stcapo/slmw/Phase_1_Review_report.md

# Phase 1 任务 Review 汇报

> Review 更新日期：2026-05-21  
> 范围：第一阶段任务、开发板选型、最终订单、采购风险边界

## 1. 最新结论

2026-05-15 版本曾将 T3-3S 作为第一阶段固定采购模组。该口径已被 2026-05-21 最终订单覆盖。

当前第一阶段主路径固定为：

```text
T5AI-Core
  -> 两路 3.3V PWM
  -> YYNMOS-4 / NMOS-4 (3-5V) MOSFET 模块
  -> 12V 恒压双色温/三色 LED 灯带
  -> 12V2A 成品隔离电源
```

核心判断：

- 可行路径：先用 T5AI-Core 和 12V 低压 LED 负载跑通 App/固件/PWM/MOSFET/灯带闭环。
- 暂不建议路径：继续购买更多开发板或围绕裸模组转接板打转。
- 后置路径：24V 需确认电源条件后再测；48V 宽压 Buck 与 48V 功率级进入 Phase 2。
- 产品化路径：最终 PCB 不直接照搬 T5AI-Core 和 YYNMOS-4，需要重新做模组、Buck、MOSFET、布局和热设计。

## 2. 已更新文件

| 文件 | 更新内容 |
| --- | --- |
| `采购现方案.md` | 改为 T5AI-Core 第一阶段最终下单版，加入截图订单明细、金额、运费、执行顺序和边界 |
| `Phase 1 原采购清单.md` | 同步 T5AI-Core 主路径、最终 BOM、验收标准和后置项 |
| `tuya_wb_3_s_solution.md` | 改为 T5AI-Core 校正版方案摘要 |
| `Agents.md` | 更新项目级口径，避免继续按 T3-3S 固定采购执行 |

## 3. 最终订单金额

| 项目 | 金额 |
| --- | ---: |
| 商品小计 | ¥1094.85 |
| 运费小计 | ¥15.00 |
| 订单总计 | ¥1109.85 |

金额按用户提供的确认订单截图记录，使用补贴后/优惠后价格。

## 4. 金额最高的核心物料

| 排名 | 物料 | 数量 | 金额 | 作用 |
| ---: | --- | ---: | ---: | --- |
| 1 | UT61E PRO 数字万用表 | 1 | ¥395.01 | 基础电测工具 |
| 2 | Kingst LA1010 逻辑分析仪 | 1 | ¥298.00 | 测 PWM/数字信号 |
| 3 | T5AI-Core 开发板 | 1 | ¥88.00 | 第一阶段主开发板 |
| 4 | 涂鸦 WiFi+蓝牙五合一 LED 控制器 | 1 | ¥68.31 | 成品对照 |
| 5 | TA610A K 型热电偶温度计 | 1 | ¥49.00 | 温升测试 |
| 6 | YYNMOS-4 / NMOS-4 (3-5V) MOSFET 模块 | 2 | ¥29.52 | 原型功率级 |

完整订单表以 `采购现方案.md` 为准。

## 5. 剩余风险

1. `YYNMOS-4 / NMOS-4` 标称最大 PWM 频率为 500Hz，第一阶段只验证原型闭环；最终产品仍应设计更高频功率级。
2. 订单中有 24V 负载，但未看到独立 24V 电源适配器；没有 24V 安全电源前，不做 24V 上电。
3. LM2596 模块不是 48V 宽压方案，不能证明 12V-48V 通用输入已经完成。
4. 灯带到货后必须确认线序、共阳/共阴和每路功率，再决定具体接线。
5. T5AI-Core 是开发板，不是最终可塞进灯具里的量产中间层。

## 6. 建议下一步

下单后停止继续扩展候选件。到货后按 `采购现方案.md` 的执行顺序，从 T5 单板上电、PWM 测量、12V 灯带闭环、温升记录四步推进。
