stcapo/slmw/handover.md

# 项目交接文档 · Handover

> 更新日期：2026-05-27  
> 项目：通用智能灯具中间层解决方案  
> 当前阶段：Phase 1 — 双路双色温硬件闭环已通过，下一步进入 Tuya App 配网/控制验证

---

## 一、项目背景（一句话）

打造一个模块化"智能中间层"，让传统灯具无需改动驱动器即可接入涂鸦 App，实现 WiFi/Zigbee 控制开关、亮度、色温。目标市场：海外非标、异形造型灯具。

---

## 二、已做过的决策（不再重复讨论）

| 决策 | 结论 | 备注 |
|---|---|---|
| 主开发板 | **T5AI-Core** 唯一主路径 | T2-U/T3-3S/WB3S/NANO 已排除出 Phase 1 |
| MOSFET 模块 | **YYNMOS-4 (3-5V)** × 2 | 原型验证用，标称最大 500Hz，不作为量产电路 |
| LED 负载 | 12V 单色灯带（优先）+ 12V/24V 双色温灯带 | 到货已确认线序 |
| 主供电 | 12V 2A 成品适配器 | 实测 12.25V，通过 |
| 工具 | UT61B+ 万用表 + LA1010 逻辑分析仪 + TA610A 热电偶 | 万用表已用电池验证 |
| 备板 | NiceMCU WB3S V1 仅作支线对照 | 不影响主路径 |
| 采购总计 | **¥1109.85**（商品 ¥1094.85 + 运费 ¥15.00） | 2026-05-21 订单，已全部到货 |

---

## 三、物料到货状态

| 物料 | 状态 |
|---|:----:|
| T5AI-Core 开发板 | ✅ 已到货 |
| YYNMOS-4/NMOS-4 MOSFET 模块 × 2 | ✅ 已到货 |
| DC 转接头 | ✅ 已到货 |
| 线材（杜邦线等） | ✅ 已到货 |
| 12V 单色暖白灯带 | ✅ 已到货 |
| 12V/24V 双色温灯带 | ✅ 已到货 |
| 12V 2A 电源适配器 | ✅ 已到货 |
| 小螺丝刀 | ✅ 已到货 |
| 万用表尖表笔 | ✅ 已到货 |
| **剥线钳** | ❌ 待补购（后续线头处理建议优先） |
| **剪钳** | ❌ 待补购（后续剪灯带建议优先） |
| 绝缘胶带 | ❌ 待补购 |
| 热缩管 | ❌ 待补购 |
| 镊子 | ❌ 待补购 |
| 打火机 / 热风枪 | ❌ 待补购（热缩管配套，可稍后） |

> ⚠️ 剥线钳和剪钳仍建议补购，用于后续更可靠地处理线头；Step 10 已用现有单根杜邦线/细鳄鱼夹/剪刀临时方案完成。

---

## 四、主线实施进度

### ✅ 已完成步骤

| 步骤 | 内容 | 关键结果 |
|---|---|---|
| Step 1 | T5AI-Core 单板上电 | 发现电源开关未打开的坑；打开后通过 |
| Step 2 | 电脑识别串口 | 枚举出 CH342F 双串口：`551`（下载）和 `553`（日志） |
| Step 3 | 串口日志查看 | TuyaOpen Tools 460800 波特率可看启动日志 |
| Step 4 | 万用表测 5V/3.3V | 5V ≈ 正常，3.3V ≈ 正常（需电源开关开启） |
| Step 5 | 烧录 PWM 冒烟测试程序 | Arduino IDE + TUYA_T5AI_CORE，写入成功，CRC 通过 |
| Step 6 | PWM 输出确认 | P24/P25 输出 200Hz 方波，占空比随程序 3 秒循环变化 |
| Step 7 | LA1010 逻辑分析仪抓波形 | 两路周期性方波已确认 |
| Step 8 | 12V 电源单独测量 | 实测 12.25V，内正外负，通过 |
| Step 9 | MOSFET 端子识别 | 丝印确认：PWM1~4 / GND1~4 / DC+ DC- / OUT1~4 ± |
| Step 10 | T5 → MOSFET → 12V 单色灯带闭环 | P24 → PWM1 成功驱动单色暖白灯带，亮度每 3 秒按 10%→50%→90%→0%→100% 变化 |
| Step 11 | P24/P25 双路双色温混光 | 双色温灯带共阳线序确认；双路 MOSFET 控制有变化；极限冷/暖两档测试通过 |

### 🔄 当前主线

**Step 11 已通过：T5AI-Core P24/P25 PWM → YYNMOS-4 PWM1/PWM2 → 12V 双色温灯带双路硬件闭环验证成功。**

关键结果：
- T5AI-Core 重新 USB 上电后，串口持续输出 `PWM_A P24 duty=...` 日志
- 12V 单色暖白灯带按预期每 3 秒经历：暗 → 中 → 亮 → 灭 → 全亮
- 说明控制侧共地、PWM1 输入、MOSFET 低边开关、12V 功率侧和 LED 极性均已跑通
- 12V/24V 双色温灯带线序已确认：红线为公共正极，黄线 WW 接负极亮暖白，白线 CW 接负极亮冷白
- `firmware/t5_cct_extreme_test/t5_cct_extreme_test.ino` 极限测试通过，冷白/暖白两档区别明确
- 冷白通道在 200Hz 下肉眼可感知闪烁，记录为原型频率风险；YYNMOS-4 标称 500Hz 上限内先不强行升频，产品化功率级后续目标应提升到 2kHz 以上

### ⏸ 待执行（下一步）

1. **执行 Step 12：Tuya App 配网/控制验证**
   ```
   App 配网
   App 开关控制
   App 亮度控制
   App 色温控制
   ```
2. **仍建议补购剥线钳、剪钳、绝缘胶带、热缩管**：后续双路/双色温线头更多，剪刀方案只能临时用。
3. **Phase 1 最终验收标准**：手机 App 可控制开关、亮度、色温；物理 PWM 闭环只是中间里程碑。

---

## 五、支线进度（NiceMCU WB3S V1）

> 纯玩备板，不影响主线任何决策。

| 步骤 | 状态 | 关键信息 |
|---|:----:|---|
| USB 上电 + 串口识别 | ✅ | 波特率 115200 |
| 查看启动日志 | ✅ | `BK7238_1.0.14` / `RT-Thread OTA` / `www.sparkleiot.com` / `ready` |
| AT 命令查询 | ✅ | AT OK，ATVER 1.1，SDKVER 3.0.70，Wi-Fi MAC `c8:47:8c:01:12:1f` |
| Wi-Fi 扫描 + 入网 | ✅ | 获取 IP `192.168.1.47`，可用 `AT+CWLAP` / `AT+WSCAN` |
| TCP 通信 | ✅ | `AT+CIPSEND=0,5` 成功发送，电脑 `nc -lk 8080` 可收到数据 |
| 下一步 | ⏸ | 支线暂停，等主线双路混光/App 控制稳定后再继续 |

---

## 六、开发环境信息

| 项目 | 信息 |
|---|---|
| 电脑系统 | macOS 12.7.6 |
| T5 下载串口 | `/dev/cu.usbmodem5AAE1666551` |
| T5 日志串口 | `/dev/cu.usbmodem5AAE1666553` |
| Arduino IDE 版本 | IDE 2，开发板包：Tuya Open |
| 开发板包地址 | `https://github.com/tuya/arduino-tuyaopen/releases/download/global/package_tuya_open_index.json` |
| 国内备用地址 | `https://gitee.com/tuya-open/arduino-tuyaopen/releases/download/global/package_tuya_open_index_cn.json` |
| 开发板选择 | `TUYA_T5AI_CORE` |
| 日志波特率 | **460800**（TuyaOpen Tools）或 Arduino Serial Monitor 115200 |
| PWM 程序路径 | `firmware/t5_pwm_smoke_test/t5_pwm_smoke_test.ino` |
| PWM 引脚 | P24（PWM_A）、P25（PWM_B），200Hz，占空比 3 秒一循环 |

---

## 七、关键边界与禁止事项

| 事项 | 说明 |
|---|---|
| **12V 绝不接 T5** | T5 用 Type-C 供电，12V 只进 MOSFET 模块和灯带 |
| **不碰 220V** | 第一阶段全程低压 DC，不接市电 |
| YYNMOS-4 频率上限 | 标称 500Hz，程序设为 200Hz，不作为量产最终电路 |
| LM2596 Buck | 只做 12V/24V 台架验证，不代表 48V 宽压方案完成 |
| 24V 测试前提 | 必须有可靠 24V 电源，不能用当前 18.5V 测 12V 负载 |
| 5-in-1 成品控制器 | 接负载后无响应，疑似损坏，已暂停不再折腾 |

---

## 八、Phase 2 当前计划（T3-3S 首板）

> 2026-06-08 更新：Phase 2 Wi-Fi 主线已锁定为 T3-3S，首板按 4 周稳妥节奏推进，由项目负责人做 PM + 技术评审，新PCB工程师 / PCB 工程师负责原理图、PCB Layout、BOM、打样文件和样板焊接配合。

- 首板目标：`T3-3S + 12/24V 输入 + 3.3V Buck + 双路低边 MOSFET + 共阳双色温 LED 输出`。
- 首板边界：低压控制 PCB，不做 220V 市电板载电源，不做 48V 宽压，不做 Zigbee，不追求极限小型化。
- PWM 映射：`T3-3S P24 -> WW`，`T3-3S P32 -> CW`，并预留 `3V3/GND/TX1/RX1/CEN/P24/P32` 测试点。
- PCB 重点：严格按 T3-3S datasheet 推荐封装建库；天线区不走线、不覆铜；keep-out 区域不上锡、不走线。
- 验收标准：12V/24V 输入均能稳定输出 3.3V；两路 PWM 可测；WW/CW 可独立驱动；30 分钟运行无异常发热、异味、重启或电源异常。
- 执行文档：
  - `Phrase2/phase2_t3_3s_pcb_schedule.md`
  - `Phrase2/phase2_t3_3s_pcb_review_checklists.md`
  - `Phrase2/phase2_t3_3s_status_log.md`

仍后移事项：

- 48V 宽压版本。
- Zigbee 版本。
- 板载 AC-DC 市电方案。
- 量产成本、认证、EMC、极限尺寸优化。

---

## 九、参考文档

| 文档 | 说明 |
|---|---|
| `Phase_1_实施手册.md` | 最权威的操作步骤，含所有实测记录 |
| `采购现方案0521.md` | 最终下单清单，金额明细 |
| `Agents.md` | 项目整体架构与三阶段计划 |
| `Phrase2/phase2_t3_3s_pcb_schedule.md` | Phase 2 T3-3S PCB 4 周排期与协作计划 |
| `Phrase2/phase2_t3_3s_pcb_review_checklists.md` | Phase 2 原理图、BOM、Layout、Gerber、Bring-up 检查清单 |
| `Phrase2/phase2_t3_3s_status_log.md` | Phase 2 站会、评审、变更、问题和测试记录模板 |
| T5AI-Core 官方文档 | https://www.tuyaopen.ai/zh/docs/hardware-specific/tuya-t5/t5-ai-core/overview-t5-ai-core |
