stcapo/slmw/Phrase2/meeting_summary_0527.txt

灯具智能控制方案及中间层设计讨论

说话人1：先讲流驱动和稳压驱动，二者区别在于输入分别为恒流、恒压。LED灯具多为串联结构，适配恒流驱动与恒压驱动。家用市电为220V，需先降压转为直流电才能驱动LED。目前行业主流做法是将控制单元集成在驱动内部，通过外置天线接收信号，实现灯具通断控制。

我们计划在LED驱动与灯体之间增设一层独立控制单元（中间层），该中间层具备宽压适配能力，可接收信号、管控灯具开关，无需原有驱动具备智能功能。该模块可对外供货给各类灯饰厂商，搭配配套服务器、APP及通信协议，就能让普通灯具接入整套智能系统。

传统智能灯具方案存在明显弊端：单独采购智能驱动成本高、适配难度大，尤其造型复杂、设计感强的花灯，很难直接配套现成智能驱动，往往需要单独定制适配，成本和门槛都很高。

再说明LED灯具色温、亮度的控制原理：灯具分为暖光、冷光两组灯珠，不同色温是通过调节两组灯珠亮度混合实现；单独点亮暖光/冷光对应单色光，同时点亮则为中性光。灯具亮度调节本质是调控回路电流，传统方式会加装电阻分流，也有PID调光等主流调光技术。

业内涂鸦智能就是主打售卖这类智能控制模块，可作为参考。整套系统需要搭建网关并制定通信协议：常供电的灯具可采用2.4G通信，电池供电设备适配蓝牙、Zigbee。网关作为中枢，可接入所有搭载中间层模块的灯具；2.4G方案还可直连WiFi，无需额外网关。

海外市场对灯具外观设计、个性化定制要求极高，市面上主流通用智能方案难以适配异形灯具，这也是我们方案的机会点。灯具主要分为传统螺口灯泡和LED面板灯、筒灯、吸顶灯两大类：螺口灯泡可直接将智能模块集成在灯体内部，适合批量生产；异形灯具则依靠外置中间层模块实现智能化。

以上是整体思路，大家可以先调研研究，我这边先处理其他事务。

说话人2：明白，相当于由中间层接管驱动输出的供电与控制信号。

说话人3：认可该方案。后续我们可以先在电商平台搜索同类智能组件、开关产品，参考市面上成熟的解决方案，采购样品测试效果。

海外市场偏好设计感强的非标灯具，主流大品牌缺少对应的供应链和适配方案，我们的方案正好契合需求。目前灯具主要就是LED集成灯、传统螺口灯泡两大形态，核心是通过中间层实现控流、调压，可采用PID控制等方式实现调光。

团队成员暂无数电、模电专业基础，硬件底层问题可咨询专业人员；团队有人具备电路板焊接、相关项目经验，可配合落地。现阶段不用急于动手开发，先收集行业资料、梳理完整方案，明确APP、中间层、通信控制等全流程设计，再讨论落地与商业化模式。

说话人2：项目还可结合边缘计算、云端计算两种模式：可采用SaaS云端部署，也可做本地网关实现本地化部署。云端方案开发难度更低，无需额外处理本地连接问题；本地网关可搭载边缘计算能力。可参考M5 Stack、乐鑫ESP32、全志H4等硬件设备，支持MQTT等通信协议。

说话人3：现阶段优先实现APP基础控灯功能，简化开发难度，基础功能跑通后再迭代新增复杂能力。建议多参考开源硬件、官方开发文档，也可借助AI工具梳理技术方案；若硬件开发遇到难题，可通过兼职、咨询外援等方式解决。

说话人2：电商平台、闲鱼上有大量智能开关、控制模块成品、原理图和开发资料，可采购样品、对接卖家获取技术参考；米家等品牌商用产品会隐藏底层原理，开源产品参考价值更高。

说话人3：本次项目主推人先吃透整体方案、理清基础概念，把控项目整体方向；硬件实操环节团队可配合，也可外部寻求技术支持。后续先完成资料调研、方案梳理，再逐步开展硬件采购、测试与开发工作，有问题线上或线下随时沟通。
二、完整内容摘要

（一）项目核心思路

本次项目聚焦普通灯具智能化改造，核心方案是在LED驱动电源与灯具光源之间增设独立智能中间层模块，摆脱对原有智能驱动的依赖。该模块支持宽压输入、信号接收，可实现灯具开关、色温、亮度调节，搭配自研服务器、APP、通信协议及网关，即可搭建完整智能灯具系统，模块可对外供货给灯饰厂商，适配各类普通灯具。

（二）技术原理与行业现状

1. 供电与驱动：家用220V市电需降压转直流才能驱动LED，LED串联灯具分为恒流、恒压两种驱动模式；传统方案将智能控制集成在驱动内，异形灯具、创意花灯难以适配，且智能驱动采购、定制成本高。

2. 灯光控制逻辑：LED灯具依靠暖光、冷光两组灯珠混光实现色温调节，通过调控回路电流实现亮度调节，主流调光方式包含PID调光、电阻分流调光。

3. 参考对标：涂鸦智能为业内成熟的智能模块供应商，其商业模式、产品形态可作为重要参考。

（三）通信与硬件选型规划

1. 通信方案：长供电灯具选用2.4G（可直连WiFi，免网关），电池供电设备选用蓝牙、Zigbee；整套系统搭配网关作为设备接入中枢，通信协议可采用MQTT。

2. 硬件载体：灯具分两类适配，螺口LED灯泡直接内置智能模块（易批量生产）；LED面板灯、筒灯、异形花灯使用外置中间层模块；硬件可参考乐鑫ESP32、M5 Stack、全志H4等开源芯片与开发板。

3. 计算架构：支持云端SaaS和本地网关+边缘计算两种模式，初期优先选择云端方案降低开发难度。

（四）市场定位与优势

重点瞄准海外市场，海外用户注重灯具外观设计与个性化定制，主流品牌缺少非标异形灯具的智能适配方案，本方案模块化、通用化的特点可完美填补市场空白。

（五）落地执行计划

1. 第一阶段（调研梳理）：在淘宝、拼多多、闲鱼等平台搜集智能开关、控制模块成品、原理图与开发文档，参考开源方案；借助AI工具梳理技术逻辑，学习数电、模电、嵌入式等基础概念。

2. 第二阶段（方案确定）：整合调研内容，输出完整整体方案，明确APP、中间层、通信、控制全流程设计，讨论落地与商业化模式。

3. 第三阶段（测试开发）：采购硬件样品进行功能测试，优先实现APP基础控灯功能；硬件底层难题可聘请外援、咨询专业人员解决，基础功能跑通后再迭代扩展能力。

4. 分工安排：项目主推人负责整体统筹、方案把控；团队成员配合硬件测试、电路焊接等工作，技术难点外部寻求支持。
