stcapo/slmw/Phrase2/meeting_summary_0602.txt

产品开发中灯带控制及硬件选型讨论

本次沟通围绕双色温智能灯带原型开发、现存问题、硬件迭代、物料准备及后续落地规划展开。

说话人3：项目第一阶段目标是完成原型验证，现阶段不自制电路板，直接使用成品开发板搭建方案。整体链路搭建流程：先在涂鸦云平台创建产品，生成对应入口，可选用平台模板小程序或自主开发小程序；
当前测试负载为12V/24V双色温灯带。

整体控制逻辑：用户在APP下发指令，数据上传至云端服务器，再转发给已配网（公司WiFi）的开发板；开发板集成WiFi、蓝牙模块，接收到指令后驱动MOS管，通过PWM信号实现灯带调光、调色温。

目前使用T5开发板，该板仅支持5V、3.3V输出，无法直接驱动灯带，外接3V电压虽能点亮但亮度不足。现阶段采用软件PWM方案，依靠程序读取CPU时钟实现电平翻转，再由MOS管完成信号放大。

当前遇到核心故障：双色温灯带调光调色温异常。暖白光拉满时无输出，冷白光拉满仅能达到一半亮度。已使用逻辑分析仪检测波形，波形显示正常，初步排查灯带本体无问题（直连电源可正常工作），
怀疑是电压不稳、MOS管性能缺陷导致该问题。目前硬件分为两块：主控开发板 + 独立四通道MOS管模块，单模块可外接4路PWM负载。

说话人4：建议整合硬件，设计一体化小板。将WiFi模组作为主控芯片，保留WiFi通信、硬件PWM两大核心功能；板内集成输入电压保护电路、降压模块，主控输出分别驱动两路MOS管，再由MOS管控制冷暖两路灯带，精简硬件结构。

说话人3：第二阶段计划替换硬件模组，备选涂鸦T3-3S小型WiFi+蓝牙模组，尺寸最小为16×24mm，且自带硬件PWM，有望解决当前软件PWM带来的电压、调光异常问题。

说话人2：判断色温、亮度异常根源就是软件PWM导致电压不稳定，更换硬件PWM模组是有效解决思路。团队目前已有万用表、逻辑分析仪，还需采购电烙铁，贴片元件较多的情况下可按需准备热风枪。当前先完成PCB图纸设计，
再外协打板，等待板材期间同步准备焊接工具。

众人沟通确认：整套方案沿用涂鸦云平台+WiFi通信架构，后续如需切换Zigbee等通信协议也具备拓展空间。选型WiFi/Zigbee主要考量通信距离、单网络设备接入数量；同时考虑海外市场使用场景，
后续主控设计会兼顾海外用户使用习惯。

说话人5：提醒一体化电路板需控制体积，灯具内部安装空间有限，模组要适配灯体底座等狭小位置。开发优先级：第一版优先跑通完整功能，暂不纠结体积、成本、功耗；功能验证完成后，再针对性优化尺寸、降本、降低功耗。

后续整体规划：

1. 完成PCB设计、外协打板、手工焊接测试，产出第一版一体化硬件样品；

2. 样品调试成功后，对接肖总沟通产品推广方案；

3. 当前仅做原型验证，暂未进入工厂量产阶段，功能全部跑通后再推进工业化量产。

二、会议完整摘要

（一）项目阶段与现有方案

1. 当前阶段：第一阶段原型验证结束，采用成品开发板+外置MOS管模块分体式方案，暂未自制PCB板。

2. 控制链路：基于涂鸦云平台搭建，APP→云端→WiFi/蓝牙开发板→MOS管→双色温灯带，支持12V/24V冷暖灯带调光、调色温。

3. 实现方式：现阶段使用软件PWM（依靠CPU时钟模拟信号）完成调光，T5开发板输出电压偏低，需借助MOS管放大信号驱动灯带。

（二）现存核心问题

双色温灯带功能异常：色温拉满时，暖白光无输出、冷白光亮度减半。经检测灯带、信号波形均正常，定位问题为软件PWM造成电压不稳定，或外置MOS管存在性能问题。

（三）优化方案与硬件选型

1. 硬件结构优化：第二阶段放弃分体式设计，制作一体化PCB小板。板载电压保护、降压电路，以涂鸦WiFi模组为主控，集成硬件PWM，直接驱动两路MOS管控制冷暖灯带，精简结构、提升稳定性。

2. 模组选型：选定涂鸦小型WiFi+蓝牙模组（T33S），体积小巧（最小16×24mm），自带硬件PWM，从根源解决软件PWM的电压缺陷。

3. 通信方案：主力采用WiFi通信，依托涂鸦云平台，预留协议拓展能力，可后续切换Zigbee；选型同时参考通信距离、带机量，并兼顾海外市场使用场景。

（四）物料与工具准备

现有设备：万用表、逻辑分析仪；
需新增工具：电烙铁（必备），根据贴片元件数量酌情配备热风枪。

（五）落地执行步骤&规划

1. 短期工作：绘制PCB图纸，委托厂家打板，到货后手工焊接、功能调试，产出第一版一体化样品；
1.1 准备相关最小前置知识学习,熟悉本阶段所需的重要概念以及流程
2. 优化迭代(后话,不计入第二阶段考量)：功能跑通后，再针对性优化电路板体积、成本、功耗，适配灯具内部安装空间；

3. 商务与量产(后话,不计入第二阶段考量)：样品测试合格后，对接负责人商讨产品推广方案；原型验证全部完成后，再启动工厂级量产；

（六）核心总结

本次灯带智能控制方案的核心瓶颈为软件PWM引发的电压与灯光控制异常，解决方案是改用带硬件PWM的涂鸦小型通信模组，并整合电路为一体化小板。整体先验证功能、再优化硬件、最后落地推广量产，WiFi为主通信方案，具备协议拓展性，同时兼顾海内外市场需求。
三、结合上一轮文档总览
1. 整体技术路线统一：均对标涂鸦智能，采用云端平台+无线模组（WiFi/蓝牙/Zigbee）+PWM调光+MOS管驱动的技术架构；

2. 产品形态区分：通用灯具采用驱动与光源之间加中间层模块，灯带类产品直接设计一体化集成控制板；

3. 技术痛点一致：LED灯光调光调色温依赖PWM信号，软件PWM稳定性差，统一转向硬件PWM作为主流方案；

4. 市场目标统一：主打海内外智能灯饰市场，硬件设计兼顾小型化、通用性、可拓展性，适配各类造型灯具。
