stcapo/slmw/purchase_0521.md

# 采购现方案（T5AI-Core 第一阶段最终下单版）

> 更新日期：2026-05-21  
> 当前原则：T5AI-Core 已确定为第一阶段主开发板，不再继续横向比较 T2-U、T3-3S 裸模组、WB3S、NANO 等开发入口。第一阶段只做低压 DC 原型验证，不接入 220V 市电。
> 实施入口：到货后按 `Phase 1 实施手册.md` 从 T5AI-Core 单板上电开始，不要一上来接 MOSFET、灯带或 Buck。

## 一、当前拍板结论

第一阶段目标收束为一件事：用 `T5AI-Core -> PWM -> MOSFET 模块 -> 12V/24V 恒压 LED 负载` 跑通 App/固件/调光闭环。

| 模块 | 当前决定 | 边界 |
| --- | --- | --- |
| 主开发板 | `T5AI-Core` | 已确定，作为第一阶段唯一主开发入口 |
| MOSFET 功率级 | `YYNMOS-4 / NMOS-4 (3-5V)`，2 块 | 原型验证可用；标称最大 PWM 频率 500Hz，不作为量产最终电路 |
| LED 负载 | 12V/24V 灯带、灯片、涂鸦成品控制器辅助验证 | 到货后确认线序，优先用 12V 负载先跑通 |
| 3.3V Buck  | LM2596 模块若干 | 只用于 12V/24V 到 3.3V 的台架验证；不覆盖 48V 宽压产品目标 |
| 测试工具 | 万用表、逻辑分析仪、热电偶温度计、USB-TTL | 一次配齐，降低后续排障成本 |

旧口径处理：

- `T3-3S`、`T2-U`、`WB3S/NiceMCU` 不再作为第一阶段主路径；NiceMCU 仅保留为便宜备板/对照实验。
- `HX-D012` 不再作为本轮第一优先采购；本轮用已选的涂鸦五合一灯带控制器做成品控制器对照。
- `XL7015E1`、宽压 48V Buck、48V MOSFET 功率级后移到 Phase 2/PCB 阶段。

## 二、最终订单清单

以下金额按截图中的优惠后/补贴后价格记录，商品金额从高到低排序；未拿到商品链接时，以店铺、标题和规格作为采购追溯信息。

### A. 商品清单（按金额从高到低）

| 排名  | 类别 | 店铺/平台 | 商品与规格 | 数量  | 商品金额 | 用途 | 备注 |
| ---:| --- | --- | --- | ---:| ---:| --- | --- |
| 1 | 测试工具 | 天猫 胜利仪器仪表自营店 | 优利德 `UT61E PRO` 数字万用表，高精度四位半 | 1 | ¥395.01 | 测电压、电流、电阻、通断 | 第一阶段核心工具 |
| 2 | 测试工具 | 天猫 七星虫旗舰店 | `Kingst LA1010` 逻辑分析仪，100M 采样率，16 通道，可调阈值，PWM 输出 | 1 | ¥298.00 | 测 PWM 频率、占空比、串口/数字信号 | 用于确认 T5 输出是否真实变化 |
| 3 | 主开发板 | 浙江涂鸦智能的小店 | 涂鸦智能 `T5AI-Core` 开发板套件，Wi-Fi/蓝牙双模 AIoT 语音交互核心板 | 1 | ¥88.00  | 第一阶段主控开发板 | 已定主路径 |
| 4 | 成品对照控制器 | 淘宝 SUNSPURT LIGHTING | 涂鸦 WiFi+蓝牙智能 LED 灯带控制器，2.4G 遥控五合一，规格：`RGBWC` 智能 30A | 1 | ¥68.31  | 成品控制器对照，验证涂鸦灯带体验 | 不代表自研中间层完成 |
| 5 | 测试工具 | 淘宝 特安斯仪器仪表店 | `TA610A` K 型热电偶测温仪，单通道加强款 | 1 | ¥49.00  | 测 MOSFET、Buck、灯带温升 | 连续运行 30 分钟记录温度 |
| 6 | MOSFET 模块  | 淘宝 单片深圳市粤豫电子 | N MOS 管模块，光耦隔离 PWM 开关场效应管驱动模块，规格：`YYNMOS-4 / NMOS-4 (3-5V)` | 2 | ¥29.52  | T5 3.3V PWM 控制 12V/24V LED 负载 | 原型可用；最大频率标称 500Hz |
| 7 | 24V LED 负载 | 淘宝 华赫照明工厂 | LED 双色温灯带 12V/24V 三色可调光，规格：`24V-8mm 宽-120 灯/5 米/2835 三色` | 1 | ¥29.35  | 第二轮 24V LED 负载验证 | 到货后确认线序/共阳方式 |
| 8 | 12V LED 负载 | 淘宝 华赫照明工厂 | LED 双色温灯带 12V/24V 三色可调光，规格：`12V-8mm 宽-120 灯/5 米/2835 三色` | 2 | ¥26.88  | 第一轮 12V LED 负载验证 | 优先用它跑通调光闭环 |
| 9 | 电容套件 | 淘宝 珅例皓被动电子元件 | 贴片电容包，0201/0402/0603/0805/1206/1210/1812，规格：`1206 电容包，16 种各 20 个` | 1 | ¥26.00  | 去耦、滤波、临时补电容 | 原型/小板返工备用 |
| 10  | 电阻套件 | 天猫 QBYDIY 旗舰店 | 130 种 2600 只 1/4W 金属膜电阻包，0.25W 全系列阻值 | 1 | ¥26.00  | 100Ω 栅极电阻、10kΩ 下拉、分压/限流 | 插件电阻适合小白调试 |
| 11  | 串口工具 | 天猫 帝特数码专营店 | USB 转 TTL 串口模块刷机线，CH340G/FT232，规格：`1m，3.3V/5V 板载式，带指示灯` | 1 | ¥18.30  | 串口日志、刷机/调试备用 | T5 自带 Type-C，TTL 作为外部调试备份 |
| 12  | 12V 电源 | 天猫 万腾世纪数码专营店 | 国标 3C 电源适配器，规格：`12V2A，接口 5.5*2.5mm，90cm 双线，带指示灯` | 1 | ¥13.90  | 第一轮 12V LED 与 MOSFET 供电 | 低压隔离电源，禁止使用裸 AC-DC |
| 13  | 备板 | 淘宝 深圳市林信世纪电子 | `NiceMCU WB3S` 开发板，WiFi 蓝牙模块，内置 BK7238，规格：焊接版 | 1 | ¥11.00  | 便宜备板/对照实验 | 不作为主路径 |
| 14  | Buck 模块 | 淘宝 深圳市林信世纪电子 | DC-DC 降压模块，`LM2596S` 带显示，双按键 | 1 | ¥5.00 | 调试型降压，观察输出电压 | 接 T5 前必须先用万用表确认输出 |
| 15  | MOSFET 裸料  | 天猫 yourcee 旗舰店 | `AO3400A` N 沟道 MOSFET，30V/5.8A，SOT-23，20 只 | 1 | ¥3.01 | 后续小板/PCB 预研 | 裸贴片料，第一阶段不用它飞线 |
| 16  | 24V 小灯片 | 淘宝 光电者 | LED-2835 灯珠光源小灯板，规格：黄光 `24V/0.5W` | 1 | ¥3.00 | 小功率 24V 负载/点亮测试 | 需要 24V 电源条件 |
| 17  | 12V 单色灯带 | 淘宝 深圳市欧尔迪照明 | LED 软灯带 12V 低压 2835，规格：`12V 120 灯珠，8mm 宽，暖白` | 1 | ¥1.77 | 单色 12V 负载测试 | 只能测单路 PWM，不测色温混光 |
| 18  | Buck 模块 | 淘宝 深圳市林信世纪电子 | DC-DC 降压模块，`LM2596` 固定输出 `3.3V` | 1 | ¥1.45 | 12V/24V 到 3.3V 台架验证 | 不覆盖 48V；先空载测再接负载 |
| 19  | Buck 模块 | 淘宝 深圳市林信世纪电子 | DC-DC 降压模块，`LM2596S` 贴片可调 | 1 | ¥1.35 | 备用可调降压 | 接入前必须调到目标电压 |

### B. 运费与合计

| 项目 | 金额 |
| --- | ---:|
| 商品小计 | ¥1094.85 |
| 深圳市林信世纪电子运费  | ¥3.50 |
| 深圳市欧尔迪照明运费 | ¥5.00 |
| 光电者运费 | ¥5.00 |
| QBYDIY 旗舰店运费 | ¥1.50 |
| 运费小计 | ¥15.00 |
| 订单总计 | ¥1109.85 |

## 三、到货后执行顺序

1. 先只给 `T5AI-Core` 接 Type-C，跑通官方示例、串口日志、基础 GPIO/PWM 输出。
2. 用万用表单独测试 `12V2A 电源`，确认空载约 12V。
3. 用 `12V 电源 -> YYNMOS-4/NMOS-4 -> 12V 双色温灯带` 跑通两路 PWM 调光；先不用 Buck 给 T5 供电。
4. 用 `LA1010` 逻辑分析仪测 T5 的两路 PWM 频率和占空比，确认 App/程序调节时信号确实变化。
5. 用 `TA610A` 记录 MOSFET 模块、灯带、Buck 模块连续运行 30 分钟温度。
6. `LM2596` 模块先单独接 12V 输入，输出确认 3.3V 后，再用假负载/小负载测试；不要一上来接 T5。
7. 12V 闭环稳定后，再做 24V 灯带/灯片测试；若没有安全可靠的 24V 电源，本轮 24V 先暂缓。

## 四、接线原则

第一轮 12V 灯带验证：

```text
12V 电源正极 -> YNMOS-4 电源正极
12V 电源负极 -> YNMOS-4 电源负极

T5 PWM1 -> YNMOS-4 PWM1
T5 GND  -> YNMOS-4 GND1
T5 PWM2 -> YNMOS-4 PWM2
T5 GND  -> YNMOS-4 GND2

YNMOS-4 输出1 -> 12V 灯带暖白一路
YNMOS-4 输出2 -> 12V 灯带冷白一路
```

到货后必须先确认灯带线序。如果灯带不是公共正极三线/多线结构，不要硬接，先重新画接线图。

## 五、关键边界

| 项目 | 当前处理 |
| --- | --- |
| PWM 频率 | `YYNMOS-4 / NMOS-4` 标称最大 500Hz，所以第一阶段验收改为“能调光、能测到占空比变化、无肉眼明显闪烁”。最终产品仍建议 >=2kHz。 |
| 48V 宽压 | 本次订单没有真正覆盖 48V 宽压 Buck，也没有 48V 功率 MOSFET。48V 后移。 |
| 24V 电源 | 订单里有 24V 灯带/灯片，但截图未看到独立 24V 电源适配器。没有 24V 电源前，不做 24V 上电测试。 |
| LM2596 | 适合 12V/24V 台架验证，不是 12-48V 产品化 Buck。 |
| AO3400A | 可作为后续 PCB 预研料；裸 SOT-23 不作为小白第一阶段主接线方案。 |
| NiceMCU WB3S | 只作备板/对照实验，不再改变主路线。 |

## 六、一句话版采购决策

本轮直接买当前订单，不再选型发散。第一阶段主线固定为 `T5AI-Core + YYNMOS-4/NMOS-4(3-5V) + 12V 双色温灯带 + 12V2A 适配器 + 测试工具`，先把低压调光闭环跑通；24V、48V、最终 PCB 和量产 MOSFET/Buck 方案全部等第一轮实测结果出来后再定。
