stcapo/slmw/Phase_1_implement_guide.md

# Phase 1 实施手册

> 启动日期：2026-05-25  
> 当前阶段：第六步，Tuya App 配网/控制验证准备  
> 原则：只做 12V 低压验证；12V 只进 MOSFET 模块和 LED，绝不接入 T5AI-Core。

## 0. 本阶段只做什么

Phase 1 的第一轮闭环最终目标是：

```text
T5AI-Core -> PWM -> YYNMOS-4/NMOS-4 -> 12V LED 灯带
```

但是第一步只验证 `T5AI-Core` 单板：

1. Type-C 供电后板子能亮、能启动。
2. 电脑能识别出 USB 串口。
3. 串口工具能看到启动日志。
4. 万用表能测到板载 `5V` 和 `3V3` 供电点正常。

通过这一步以后，再进入 PWM 单测；不要一开始就把 MOSFET、灯带、Buck 全部接上。

## 1. 准备物料

| 物料 | 本步是否使用 | 说明 |
| --- | --- | --- |
| T5AI-Core 开发板 | 使用 | 主角 |
| Type-C 数据线 | 使用 | 必须是数据线，不只是充电线 |
| 电脑 | 使用 | 当前电脑是 macOS 12.7.6 |
| 万用表 | 使用 | UT61B+、UT61E PRO 或同级都可以 |
| 12V2A 电源 | 不使用 | 下一步再测 |
| YYNMOS-4/NMOS-4 | 不使用 | PWM 跑通后再接 |
| LED 灯带 | 不使用 | MOSFET 接线确认后再接 |
| LM2596 Buck | 不使用 | 后面单独测，不能直接接 T5 |

## 2. 上电前检查

先把桌面清空，只放 `T5AI-Core + Type-C 线 + 万用表`。

检查顺序：

1. 板子下面不要垫金属物。
2. 不要把任何杜邦线、12V 电源线、灯带线接到 T5。
3. Type-C 线先不要插电脑。
4. 肉眼看板子有没有明显断针、歪针、金属屑、烧焦、破损。
5. 如果后续要量电压，万用表黑表笔固定碰 `GND`，红表笔去碰 `5V` 或 `3V3`。

## 3. 电脑识别串口

当前未插 T5 时，本机只看到：

```text
/dev/cu.Bluetooth-Incoming-Port
```

所以插上 T5 后，应该多出来新的 `/dev/cu.*` 串口设备。T5-AI 官方引脚图标注板载 `Dual Channel Serial (CH342F)`：

- `CH1`：串口下载，连接 `P10/P11`
- `CH2`：串口调试，连接 `P0/P1`

操作：

```bash
ls /dev/cu.*
```

记录插线前后的差异。

通过标准：

```text
插线前：只有 Bluetooth 或少数已有串口
插线后：多出 1-2 个 USB/serial/WCH/CH34x 相关串口
```

如果没有新增串口，优先怀疑：

1. Type-C 线只是充电线。
2. 板子没供上电。
3. CH342/CH34x 驱动没有生效。
4. USB 口/转接头异常。

## 4. 串口日志

推荐先用官方网页工具，不急着装复杂开发环境：

```text
https://tuyaopen.ai/tools/
```

使用 Chrome 或 Edge 打开。

串口调试参数先用：

```text
目标设备：T5AI 或自定义
波特率：115200
数据位：8
停止位：1
校验位：无
```

连接后按一下 T5 板上的 `RESET`。如果串口正确，接收窗口通常会出现启动日志。

通过标准：

```text
能连接串口
按 RESET 后有日志滚动
日志里没有持续重启、异常乱码、烧录失败等明显错误
```

如果 115200 没有日志，先不要乱烧录，后续再按官方工具支持的 921600/1500000 等速率排查。

## 5. 万用表测电压

万用表设置：

```text
档位：直流电压 V DC
黑表笔：GND
红表笔：5V 或 3V3
```

预期结果：

| 测点 | 正常范围 | 说明 |
| --- | --- | --- |
| `5V` 对 `GND`  | 约 4.75V-5.25V | Type-C 供电  |
| `3V3` 对 `GND` | 约 3.20V-3.40V | 板载 3.3V 电源 |

注意：

- 表笔不要同时碰到相邻两个针脚。
- 不要用电流档去测电压。
- 不确定表笔位置时先拍照标注，再测。

## 6. 第一页记录模板

```text
日期：
T5AI-Core 是否亮灯：
插线后新增串口名称：
串口工具是否能连接：
RESET 后是否有日志：
5V 实测：
3V3 实测：
异常现象：
结论：通过 / 未通过
```

## 8. 2026-05-25 第一次实测记录

```text
日期：2026-05-25
插线前串口：
  /dev/cu.Bluetooth-Incoming-Port
插线后新增串口：
  /dev/cu.usbmodem5AAE1666553
  /dev/cu.usbmodem5AAE1666551
TuyaOpen Tools：
  /dev/cu.usbmodem5AAE1666551 可连接
  工具显示 Serial connected successfully
当前判断：
  USB 数据线、电脑 Web Serial、T5 板载 USB 串口枚举已通过
  但当前收到的是网页工具的环境信息，不等于已经看到 T5 启动日志
待复核：
  RESET 后是否有 T5 启动日志
  /dev/cu.usbmodem5AAE1666553 是否为调试日志口
  5V/3V3 电压测量点和万用表档位
```

## 9. 2026-05-25 第二次实测记录

```text
电池校验：
  万用表测一节电池为 1.601V，万用表基本可用
T5 电压：
  用户复测 5V/3.3V 仍接近 0V
串口：
  /dev/cu.usbmodem5AAE1666551 和 /dev/cu.usbmodem5AAE1666553 均已尝试
  按 RESET 后未看到 T5 启动日志
当前判断：
  仍不能直接判定板子损坏
  因为 USB Dual Serial 已经枚举，说明 USB 数据线、USB 口、CH342F 串口芯片至少已上电
下一步排查：
  1. 确认板上 POWER/PW LED 是否亮
  2. 按官方引脚图重新确认 GND、5V、3V3 的金属测点
  3. 串口日志波特率优先尝试 460800，再尝试 115200
  4. 如确认官方 5V/3V3 引脚仍为 0V 且电源灯不亮，联系卖家换板
```

## 10. 2026-05-25 第三次实测记录

```text
问题原因：
  T5AI-Core 板上电源开关未打开
修正后结果：
  打开电源开关后，RESET 有启动日志
  5V 和 3.3V 测点电压恢复正常
当前结论：
  Phase 1 第一步通过
  可以进入 PWM 空载单测
```

## 10.1 2026-05-25 烧录记录

```text
烧录端口：
  /dev/cu.usbmodem5AAE1666551
日志端口：
  /dev/cu.usbmodem5AAE1666553
烧录结果：
  Write flash success
  CRC check success
  Reboot done
  Flash write success
后置提示：
  tyutool_cli 报 No such option: -B
当前判断：
  Flash 写入和校验已成功，程序大概率已烧入
  -B 报错属于烧录后工具调用参数问题，暂不作为失败处理
下一步：
  打开日志端口 553，确认是否输出 PWM smoke test 日志
```

## 10.2 2026-05-25 PWM 程序运行记录

```text
TuyaOpen Tools：
  选择 T5AI 时，串口波特率固定为 460800
  553 端口按 RESET 能看到 bootloader / l2 boot / app startup / go to tuya 等启动日志
  选择 custom 并改 115200 时，boot 阶段可能乱码
Arduino Serial Monitor：
  553 端口能看到 PWM smoke test 输出
  示例：
    PWM_A P24 duty=90%, PWM_B P25 duty=10%, freq=200Hz
    PWM_A P24 duty=0%, PWM_B P25 duty=100%, freq=200Hz
逻辑分析仪：
  LA1010 已抓到两路周期性数字波形
当前判断：
  T5AI-Core 已成功运行自定义程序
  P24/P25 已有 PWM 输出
  下一步只需确认 CH0/CH1 与 P24/P25 的接线映射、频率约 200Hz、占空比随日志变化
```

## 11. 第二步：PWM 空载单测

目标：让 T5AI-Core 输出两路 3.3V PWM 信号，并用 Kingst LA1010 逻辑分析仪确认频率和占空比。

本步仍然不接：

- 12V2A 电源
- YYNMOS-4/NMOS-4 模块
- LED 灯带
- LM2596 Buck

### 11.1 使用的测试程序

本项目已新增一个 Arduino 冒烟测试程序：

```text
firmware/t5_pwm_smoke_test/t5_pwm_smoke_test.ino
```

测试程序输出：

| 引脚 | 作用 | 频率 | 占空比变化 |
| ----- | ----- | -----:| --- |
| `P24` | PWM_A | 200Hz | 10% -> 50% -> 90% -> 0% -> 100% |
| `P25` | PWM_B | 200Hz | 90% -> 50% -> 10% -> 100% -> 0% |

选择 200Hz 是为了后续接 YYNMOS/NMOS 模块时不超过其标称 500Hz 上限。这个程序是原型验证用，不代表最终产品 PWM 实现。

### 11.2 Arduino IDE 设置

官方 Arduino-TuyaOpen 框架支持 `TUYA_T5AI`，且支持 macOS。

Arduino IDE 2 开发板管理器地址：

```text
https://github.com/tuya/arduino-tuyaopen/releases/download/global/package_tuya_open_index.json
```

设置步骤：

1. 安装并打开 Arduino IDE 2。
2. 如果 Arduino IDE 提示 `Sign in`，直接跳过。只做本地编译/烧录不需要 Arduino 账号。
3. 打开 `文件 -> 首选项`。
   - macOS 顶部菜单通常是 `Arduino IDE -> Settings...` 或 `Arduino IDE -> Preferences...`
   - 也可以按快捷键 `Command + ,`
   - 中文界面可能显示为 `Arduino IDE -> 设置...` 或 `Arduino IDE -> 首选项...`
4. 在 `其他开发板管理器地址` 填入上面的地址。
5. 打开 `开发板管理器`：
   - Arduino IDE 2 左侧边栏第二个图标，像一块小板子/芯片
   - 或顶部菜单 `工具 -> 开发板 -> 开发板管理器...`
   - 英文界面是 `Tools -> Board -> Boards Manager...`
6. 在开发板管理器搜索 `Tuya Open` 并安装。
7. 开发板选择 `TUYA_T5AI_CORE`；如果菜单没有这个名字，再选 `TUYA_T5AI_BOARD` 或 `TUYA_T5AI`。
8. 关闭 TuyaOpen Tools 网页串口，避免串口被占用。
9. 端口选择下载口。T5AI 有两个串口，能看日志的是调试口，另一个通常是烧录口；如果烧录失败，就换另一个端口。
10. 打开并烧录 `firmware/t5_pwm_smoke_test/t5_pwm_smoke_test.ino`。

常见卡点：

- `Select Other Board and Port` 弹窗只是选择已经安装好的板，不是安装开发板包的地方。
- 如果只看到 `Arduino AVR Boards`、`Arduino ESP32 Boards` 等，说明 Tuya Open 开发板包还没有安装。
- 板名是 `TUYA_T5AI_CORE`，不是 `TUYA_T4AI_CORE`。
- 如果 GitHub 地址搜索不到 `Tuya Open`，把开发板管理器地址换成国内 Gitee 地址：

```text
https://gitee.com/tuya-open/arduino-tuyaopen/releases/download/global/package_tuya_open_index_cn.json
```

烧录会覆盖当前板子的出厂示例固件。当前项目目标是做自研原型验证，可以接受；如果需要保留出厂示例，先记录当前日志和现象。

### 11.3 LA1010 接线

只接逻辑分析仪，不接任何 12V 负载。

```text
LA1010 GND -> T5 GND
LA1010 CH0 -> T5 P24
LA1010 CH1 -> T5 P25
```

LA1010 设置建议：

| 项目 | 设置 |
| ---- | --- |
| 采样率  | 1MS/s 起步 |
| 阈值 | 1.8V 或 3.3V 逻辑阈值 |
| 采样时长 | 5s-10s |
| 解码 | 不需要协议解码，只看方波 |

### 11.4 通过标准

| 检查项 | 通过标准 |
| ----- | --- |
| 串口日志  | 烧录后串口每 3 秒输出一次 duty 信息 |
| `P24` | 约 200Hz 方波，占空比随日志变化 |
| `P25` | 约 200Hz 方波，占空比与 `P24` 反向变化 |
| 电平 | 低电平接近 0V，高电平约 3.3V |
| 安全 | 测试期间 T5 不重启、不发烫、无异味 |

通过后，下一步才是 `12V 电源单独测量` 和 `MOSFET 模块低压接线前检查`。

## 12. 当前阶段不能做的事

- 不接 12V 电源到 T5。
- 不接 MOSFET 模块。
- 不接 LED 灯带。
- 不调 LM2596 给 T5 供电。
- 不烧录陌生固件。
- 不把万用表电流档并到电源两端。

PWM 空载单测通过后，下一步才是 `12V 电源单测` 和 `MOSFET 模块接线前检查`。

## 13. 第三步：12V2A 电源单独测量

目标：确认 12V2A 成品适配器输出电压正常，并确认输出正负极。此步骤只测电源，不接 T5、不接 MOSFET、不接灯带。

### 13.1 准备

| 物料 | 用途 |
| --- | --- |
| 12V2A 成品适配器 | 被测电源 |
| 万用表 | 测直流电压和极性 |
| 绝缘胶带/纸板 | 防止输出线短路  |

桌面只放 12V 电源和万用表。输出端红黑线或圆头插头不要碰在一起。

### 13.2 万用表设置

```text
黑表笔 -> COM
红表笔 -> V/Ω
档位 -> 直流电压 V DC
手动量程 -> 20V 或 60V 档
自动量程 -> 直接选 V DC
```

不要使用：

- 电流档 `A/mA/uA`
- 电阻档 `Ω`
- 蜂鸣/通断档
- 交流电压 `V~`

### 13.3 如果输出是红黑两根线

1. 先不要插 220V。
2. 把红线和黑线分开，避免两根线碰到。
3. 插上 12V 适配器。
4. 黑表笔碰黑线金属端。
5. 红表笔碰红线金属端。
6. 读万用表数值。

判断：

| 读数 | 含义 |
| --- | --- |
| `+11.4V` 到 `+12.6V` 左右 | 正常；红线是正极，黑线是负极 |
| `-11.4V` 到 `-12.6V` 左右 | 电压正常，但表笔/线极性反了 |
| 接近 `0V` | 未供电、表笔没碰到金属、档位错误或电源异常 |
| 明显不是 12V，如 5V/24V | 电源型号不对，先不要继续 |

### 13.4 如果输出是圆形 DC 插头

常见 5.5mm DC 圆头通常是内正外负，但必须实测确认。

1. 插上 12V 适配器。
2. 黑表笔碰圆头外圈金属。
3. 红表笔轻轻伸进圆孔中心，碰里面的金属触点。
4. 不要让红表笔同时碰到外圈，否则会短路。
5. 读万用表数值。

判断：

| 读数 | 含义 |
| --- | --- |
| `+11.4V` 到 `+12.6V` 左右 | 内芯是正极，外圈是负极 |
| `-11.4V` 到 `-12.6V` 左右 | 内芯是负极，外圈是正极 |
| 接近 `0V` | 没碰到中心金属、适配器未上电或电源异常 |

### 13.5 记录模板

```text
日期：
电源标签标称：
输出形式：红黑线 / DC 圆头
万用表档位：
实测电压：
极性判断：
适配器指示灯是否亮：
结论：通过 / 未通过
```

通过标准：

```text
空载输出约 12V
正负极明确
输出线没有短路
无异味、无异常发热
```

此步骤通过后，下一步进入 `YYNMOS-4/NMOS-4 模块接线前检查`。

## 13.1 2026-05-25 12V 电源实测记录

```text
输出形式：
  圆形 DC 插头
实测电压：
  12.25V
极性：
  内芯正极，外圈负极
状态：
  输出线没有短路
  无异味、无异常发热
结论：
  12V2A 适配器单测通过
```

## 14. 第四步：YYNMOS-4/NMOS-4 接线前检查

目标：确认 MOSFET 模块端子、T5 控制信号和 12V LED 负载接线方向。此步骤先不上电，先看清端子。

### 14.1 模块端子理解

YYNMOS-4/NMOS-4 是低边开关模块，逻辑可以理解成：

```text
12V 电源正极 -> 模块电源正极 -> 模块各路输出+
模块各路输出- -> MOSFET 开关 -> 12V 电源负极
```

控制侧：

```text
T5 PWMx -> 模块 PWMx
T5 GND  -> 模块 GNDx
```

功率侧：

```text
12V 适配器正极 -> 模块 电源正极
12V 适配器负极 -> 模块 电源负极
模块 输出x+ -> LED 负载正极
模块 输出x- -> LED 负载负极
```

### 14.2 接线前必须确认

| 检查项 | 通过标准 |
| --- | --- |
| 模块规格 | 使用 `NMOS-4 (3-5V)` 或 `YYNMOS-4 (3-5V)` |
| 电源输入端  | 能在模块上找到 `电源正极`、`电源负极` 或 `DC+`、`DC-` |
| 输出端 | 能找到 `输出1+ / 输出1-`、`输出2+ / 输出2-` |
| 控制端 | 能找到 `PWM1/GND1`、`PWM2/GND2` |
| LED 负载 | 先用 12V 单色暖白灯带或确认好线序的 12V 负载 |
| T5 状态  | PWM 程序已运行，P24/P25 有 200Hz 输出 |

### 14.2.1 2026-05-25 模块照片确认

用户已提供 YYNMOS-4/NMOS-4 正反面照片，背面丝印可见：

控制侧：

```text
PWM1 GND1
PWM2 GND2
PWM3 GND3
PWM4 GND4
```

功率侧：

```text
DC+
DC-
OUT1+
OUT1-
OUT2+
OUT2-
OUT3+
OUT3-
OUT4+
OUT4-
```

当前第一轮只使用：

```text
PWM1 / GND1
DC+ / DC-
OUT1+ / OUT1-
```

### 14.2.2 没有 DC 母座转接头时的处理

优先推荐购买 `5.5*2.5mm DC 母座转螺丝端子` 或 `5.5*2.5mm DC 母座转红黑线`。如果要马上验证，可以剪开 12V 适配器的低压输出线。

只允许剪：

```text
12V 适配器 -> 圆形 DC 插头 这一侧的低压输出线
```

绝对不剪：

```text
插墙/插排的 220V 输入线
```

剪线步骤：

1. 拔掉 12V 适配器的 220V 插头。
2. 等 10 秒。
3. 在靠近圆形 DC 插头后方约 5cm-10cm 的位置剪断输出线；保留圆头小尾巴，后续需要时还能识别或改造。
4. 把适配器输出侧两根线分开。
5. 每根线剥皮约 5mm-7mm。
6. 先不要接模块，重新插上适配器。
7. 用万用表直流电压档测两根裸线。
8. 读数为 `+12V` 时，红表笔碰到的那根是 `12V+`，黑表笔碰到的是 `12V-`。
9. 拔掉适配器。
10. 给 `12V+` 贴红色胶带或写 `+`，给 `12V-` 贴黑色胶带或写 `-`。

如果剪开后发现不是两根普通导线，而是同轴结构：

```text
中间一根芯线 + 外面一圈铜丝/屏蔽层
```

通常中间芯线是正极，外层铜丝是负极，但仍然必须用万用表复测后再接。

处理后的线头要求：

- 正负两根线不能有散开的铜丝互相碰到。
- 裸铜长度只露出能进端子的 5mm-7mm。
- 不接线时，两根裸线要分开并临时包胶带。
- 插电测量时手不要碰裸铜。

### 14.3 第一轮推荐只接单路

为了降低风险，第一轮只接一路 LED，不接双色温/多路灯带。

推荐顺序：

```text
T5 P24 -> MOSFET PWM1
T5 GND -> MOSFET GND1

12V 正极 -> MOSFET 电源正极
12V 负极 -> MOSFET 电源负极

MOSFET 输出1+ -> 12V 单色灯带正极
MOSFET 输出1- -> 12V 单色灯带负极
```

如果没有剪开圆形 DC 插头，先不要硬接。需要用 DC 母座转接线、鳄鱼夹转接线，或把适配器输出安全转成两根明确的正负线后再接模块端子。

### 14.4 上电顺序

1. T5 先用 Type-C 上电，确认串口输出 PWM 日志。
2. MOSFET 模块先不接 12V，只接 `T5 P24 -> PWM1` 和 `T5 GND -> GND1`。
3. 断开 12V 适配器市电。
4. 把 12V 正负接到 MOSFET 模块电源输入。
5. 把 LED 单路接到 `输出1+ / 输出1-`。
6. 复查没有铜丝短路。
7. 插上 12V 适配器。
8. 观察 LED 是否随 PWM 日志明暗变化。

### 14.5 立即断电条件

出现以下任一情况，立刻拔 12V 适配器：

- LED 不正常爆亮且无法变化
- 模块冒烟、异味、发烫
- 12V 电源指示灯闪烁或熄灭
- T5 重启、电脑串口断开
- 接线端子有火花或铜丝碰线

通过标准：

```text
单路 LED 能随 P24 duty 变化而明暗变化
T5 不重启
MOSFET 模块不异常发热
12V 电源稳定
```

### 14.6 2026-05-27 转接件到货后的实操步骤

本轮目标：

```text
T5AI-Core P24 PWM -> YYNMOS-4 PWM1 -> 12V 单色 LED 灯带明暗变化
```

只使用一路：

```text
PWM1 / GND1
DC+ / DC-
OUT1+ / OUT1-
```

#### 14.6.1 先测 DC 母座转接头

1. 不接 MOSFET，不接 LED。
2. 把 `12V2A 适配器` 插入 `DC 母座转接头`。
3. 万用表直流电压档：

```text
红表笔 -> 转接头 +
黑表笔 -> 转接头 -
```

4. 预期读数：

```text
约 12.25V
```

5. 如果读数是负数，说明转接头标注/线色与实际相反，按万用表实测重新标正负。
6. 测完拔掉 12V 适配器。

#### 14.6.2 接 T5 控制侧

T5 先用 Type-C 上电，确认 Arduino Serial Monitor 还能看到 PWM 日志：

```text
PWM_A P24 duty=...
PWM_B P25 duty=...
```

然后接：

```text
T5 P24 -> MOSFET PWM1
T5 GND -> MOSFET GND1
```

注意：

- 不接 T5 的 `5V`。
- 不接 T5 的 `3V3`。
- 不把 12V 接到 T5。
- 鳄鱼夹夹 T5 排针时要避开相邻针脚，不能让金属夹同时碰两根针。

#### 14.6.3 接 MOSFET 功率侧

确认 12V 适配器仍然拔掉，再接：

```text
DC 母座转接头 + -> MOSFET DC+
DC 母座转接头 - -> MOSFET DC-
```

推荐用螺丝端子压紧裸线或杜邦线金属端，不要只靠手按。

#### 14.6.4 接单色 12V LED

先用 `12V 单色暖白灯带`，不要先接双色温三线灯带。

```text
LED 正极 / +12V / 红线 -> MOSFET OUT1+
LED 负极 / - / 黑线或白线 -> MOSFET OUT1-
```

如果灯带没有红黑线，只看焊盘丝印：

```text
+12V / + -> OUT1+
- / GND -> OUT1-
```

#### 14.6.5 上电前复查

上电前逐项确认：

```text
T5 P24 只接 PWM1
T5 GND 只接 GND1
12V+ 只接 DC+
12V- 只接 DC-
LED+ 只接 OUT1+
LED- 只接 OUT1-
T5 没有接到 12V
端子没有散铜丝短路
```

#### 14.6.6 上电观察

1. T5 保持 Type-C 供电，PWM 程序运行。
2. 插上 12V 适配器。
3. 观察 LED。

预期现象：

```text
LED 每 3 秒左右变化一次亮度
大致会经历：暗 -> 中 -> 亮 -> 灭 -> 全亮
```

因为当前 P24 程序 duty 是：

```text
10% -> 50% -> 90% -> 0% -> 100%
```

#### 14.6.7 如果不亮

先拔掉 12V 适配器，再排查：

```text
1. Arduino Serial Monitor 是否还在输出 PWM_A P24 日志
2. T5 P24 是否确实接到 PWM1
3. T5 GND 是否确实接到 GND1
4. 12V+ / 12V- 是否接到 DC+ / DC-
5. LED 正负是否接反
6. 是否误接到 OUT2/OUT3/OUT4
```

可以用万用表辅助测：

```text
MOSFET DC+ 对 DC- 应约 12V
T5 P24 对 T5 GND 平均电压会随 duty 变化
```

#### 14.6.8 如果异常

出现以下情况立刻拔掉 12V：

```text
冒烟
异味
端子打火
MOSFET 模块迅速发烫
12V 适配器指示灯闪烁/熄灭
T5 重启或 USB 断开
LED 爆亮且无法变化
```

#### 14.6.9 通过后记录

```text
日期：
12V 实测：
使用 LED：
P24 -> PWM1 是否确认：
LED 是否随 3 秒 duty 变化：
MOSFET 温度：
T5 是否重启：
异常：
结论：通过 / 未通过
```

#### 14.6.10 2026-05-27 Step 10 单路闭环实测记录

```text
日期：2026-05-27
当前工具状态：
  剥线钳、剪钳尚未到货
  已有单根母对母线和可夹单个排针的细鳄鱼夹
  12V 单色暖白灯带线头已剪开并露出铜丝，灯带有 +12V 丝印
T5 状态：
  USB 供电后 Arduino Serial Monitor 持续输出 PWM 日志
  P24 duty 循环：10% -> 50% -> 90% -> 0% -> 100%
接线：
  T5 P24 -> YYNMOS-4 PWM1
  T5 GND -> YYNMOS-4 GND1
  DC 转接头红线 -> YYNMOS-4 DC+
  DC 转接头黑线 -> YYNMOS-4 DC-
  12V 单色灯带 +12V/红线 -> YYNMOS-4 OUT1+
  12V 单色灯带负极/黑线 -> YYNMOS-4 OUT1-
结果：
  12V 灯带每 3 秒按 暗 -> 中 -> 亮 -> 灭 -> 全亮 变化
  单路低压 PWM 闭环验证通过
结论：
  Step 10 通过
  下一步进入 P24/P25 双路双色温混光验证
```

### 14.7 第五步准备：双色温灯带线序确认

#### 14.7.1 2026-05-27 双色温灯带线序实测记录

```text
测试方法：
  红线接 12V 电源正极
  黄线 WW 接 12V 电源负极，灯带亮暖白
  白线 CW 接 12V 电源负极，灯带亮冷白
结论：
  该双色温灯带为共阳极结构
  红线 = 公共正极 / +12V 或 +24V
  黄线 = WW 暖白负极通道
  白线 = CW 冷白负极通道
```

#### 14.7.2 下一步双路 MOSFET 接线计划

本步目标：

```text
T5AI-Core P24 -> YYNMOS-4 PWM1 -> 黄线 WW 暖白通道
T5AI-Core P25 -> YYNMOS-4 PWM2 -> 白线 CW 冷白通道
```

推荐接线：

```text
控制侧：
  T5 P24 -> MOSFET PWM1
  T5 P25 -> MOSFET PWM2
  T5 GND -> MOSFET GND1
  T5 GND -> MOSFET GND2

功率输入：
  DC 转接头红线 / 12V+ -> MOSFET DC+
  DC 转接头黑线 / 12V- -> MOSFET DC-

双色温灯带：
  红线公共正极 -> MOSFET OUT1+（或模块 DC+ / 任一路 OUT+，以丝印和实测为准）
  黄线 WW 暖白负极 -> MOSFET OUT1-
  白线 CW 冷白负极 -> MOSFET OUT2-
```

注意：

```text
红线公共正极不能接到 OUT1- 或 OUT2-
黄线/白线不要再直接接电源负极，改由 MOSFET OUT1-/OUT2- 控制
12V 仍然绝不接入 T5AI-Core
```

#### 14.7.3 2026-05-27 双路双色温混光实测记录

```text
接线：
  T5 P24 -> YYNMOS-4 PWM1 -> 黄线 WW 暖白负极
  T5 P25 -> YYNMOS-4 PWM2 -> 白线 CW 冷白负极
  T5 GND -> YYNMOS-4 GND1/GND2
  12V+ -> YYNMOS-4 DC+ / 灯带红线公共正极
  12V- -> YYNMOS-4 DC-
测试程序：
  firmware/t5_pwm_smoke_test/t5_pwm_smoke_test.ino
观察：
  灯光有周期性变化
  初始五档程序下，偏冷/中性/偏暖的肉眼区分不够明显
  T5 未重启，12V 电源稳定，未记录冒烟、异味、打火等异常
判断：
  双路双色温硬件闭环初步通过
  通道方向和色温映射后续可在 App 控制阶段校准
```

#### 14.7.4 2026-05-27 极限冷暖两档测试记录

新增测试程序：

```text
firmware/t5_cct_extreme_test/t5_cct_extreme_test.ino
```

程序只在两档之间切换：

```text
PURE_COLD:
  WW P24 duty = 0%
  CW P25 duty = 100%

PURE_WARM:
  WW P24 duty = 100%
  CW P25 duty = 0%
```

实测结论：

```text
极限冷白 / 极限暖白两档区别明确
双路 MOSFET 控制有效
Step 11 双路双色温硬件闭环通过
```

遗留现象：

```text
冷白通道肉眼能感觉到闪烁
当前 PWM 频率为 200Hz，属于原型阶段低频测试
YYNMOS-4/NMOS-4 标称最大 PWM 频率为 500Hz，因此本阶段先记录问题，不强行作为量产调光体验验收
后续产品化 MOSFET 功率级和正式固件应提升 PWM 频率，目标至少 2kHz 以上
```

## 15. 支线：涂鸦 WiFi+BT 5-in-1 成品灯带控制器测试

> 日期：2026-05-26  
> 目的：先独立验证成品灯带控制器的使用方式，不接 T5AI-Core，不接 YYNMOS/NMOS 模块。

### 15.1 当前观察

用户反馈：

```text
控制器不接负载时，Pilot lamp 不常亮
反复插拔电源时，Pilot lamp 偶尔蓝灯闪一下后熄灭
控制器标称输入：DC12-24V
实测当前供电：约 18.5V
```

当前判断：

- 蓝灯闪一下不等于控制器烧坏，可能是上电瞬间、模式状态或配网状态提示。
- 不接负载时指示灯不常亮，不一定异常。
- 该控制器不是 Buck 降压器，输出电压基本等于输入电压。
- 18.5V 不适合接 12V 灯带；可以用于 24V 灯带低亮度验证。

### 15.2 只接 24V CCT/双色温灯带

若 24V 灯带是三线双色温/CCT，常见线序为：

```text
V+  -> 公共正极
WW  -> 暖白负极通道
CW  -> 冷白负极通道
```

接控制器输出端：

```text
灯带 V+  -> 控制器 V+
灯带 WW  -> 控制器 WW
灯带 CW  -> 控制器 CW
```

如果灯带线颜色是红/黄/白，通常先按：

```text
红线 -> V+
黄线 -> WW
白线 -> CW
```

黄线和白线接反一般只会导致冷暖方向反了，后续可以互换；红线不能接错。

### 15.3 上电前检查

1. 控制器输入端只接当前 `18.5V` 电源，不接 T5。
2. 输出端只接 24V 灯带，不接 12V 灯带。
3. 灯带红线或 `+24V/V+` 必须接控制器 `V+`。
4. 另外两根线只接 `WW/CW`，不要接到 `R/G/B`。
5. 线头不能有散铜丝互相碰到。

### 15.4 输出模式设置

该控制器是 5-in-1，需要切到 CCT/Dual White 模式。

操作：

```text
短按 SET -> 切换输出模式
看到 Pilot lamp 黄灯闪烁 -> CCT/Dual White 模式
```

不要长按 SET，长按通常用于配网/重置。

### 15.5 通过标准

```text
24V 灯带能亮
短按 SET 后可切到 CCT/Dual White 模式
手机 App 或控制器状态能控制开关/亮度/色温
控制器无异味、无异常发热
电源无异常叫声、闪烁、过热
```

如果灯不亮：

```text
先断电
确认 V+ 是否接到灯带正极
确认是否在 CCT 模式
确认控制器是否处于 App 关闭状态
确认 18.5V 供电是否仍稳定
```

### 15.6 异常记录：接负载后仍无输出

用户反馈：

```text
换接 24V 灯带后，控制器接上负载仍无明显响应
怀疑 5-in-1 成品控制器已损坏
```

当前处理：

- 暂停反复插拔电源。
- 不再接 12V 灯带。
- 先做控制器输入与输出的万用表验证。

排查顺序：

```text
1. 只测电源空载输出，确认仍为约 18.5V
2. 电源接入控制器 INPUT 后，测控制器 INPUT + / - 是否仍为约 18.5V
3. 控制器接电但不接灯带，测 OUTPUT V+ 与 WW/CW/R/G/B 之间是否有电压变化
4. 短按 SET 切模式，每次切换后再测输出
5. 若 INPUT 正常但所有 OUTPUT 通道始终无响应，控制器损坏或处于不可用状态的概率较高
```

## 16. 支线：NiceMCU WB3S V1 最小 setup 测试

> 日期：2026-05-26  
> 目的：把 NiceMCU WB3S V1 当作便宜备板/对照实验板玩一玩；不改变 T5AI-Core 主路径。

### 16.1 当前原则

第一轮只做：

```text
USB 上电
电脑识别串口
测 3.3V
查看启动日志
确认板子没有异常发热
```

第一轮不做：

```text
不接 12V
不接 MOSFET
不接 LED 灯带
不刷 OpenBeken / LibreTiny / 其他第三方固件
不把 T5 的程序直接套到 WB3S
```

### 16.2 准备物料

| 物料 | 用途 |
| --- | --- |
| NiceMCU WB3S V1 | 被测备板 |
| USB 数据线 | 供电与串口 |
| 电脑 | 识别串口、看日志 |
| 万用表 | 测 `5V`、`3V3`、`GND` |

### 16.3 上电前检查

1. 桌面不要放金属物。
2. 只接 USB，不接外部电源。
3. 看板上是否有 `5V`、`3V3`、`GND` 丝印。
4. 看是否有 `BOOT`、`RST`、`EN` 或类似按键。
5. 看 USB 口附近是否有 CH340/USB 串口芯片。

### 16.4 电脑识别串口

插板前先查：

```bash
ls /dev/cu.*
```

插上 NiceMCU WB3S 后再查一次：

```bash
ls /dev/cu.*
```

通过标准：

```text
多出一个 /dev/cu.usbserial*、/dev/cu.wchusbserial*、/dev/cu.usbmodem* 等串口
```

如果没有新增串口：

- 换 USB 数据线。
- 换 USB 口。
- 检查 macOS 是否需要 CH340/WCH 驱动。
- 看板上电源灯是否亮。

### 16.5 万用表测电压

USB 供电后测：

```text
黑表笔 -> GND
红表笔 -> 5V
红表笔 -> 3V3
```

通过标准：

| 测点 | 正常范围 |
| --- | --- |
| `5V` 对 `GND`  | 约 4.75V-5.25V |
| `3V3` 对 `GND` | 约 3.20V-3.40V |

如果 `3V3` 不正常，先停止，不继续串口/刷机。

### 16.6 查看启动日志

用 Arduino Serial Monitor、串口助手或 TuyaOpen Tools 的 custom 串口模式都可以。

先试：

```text
波特率：115200
数据位：8
停止位：1
校验：无
```

操作：

1. 选择新增串口。
2. 打开串口监视器。
3. 按一下板上的 `RST` 或重新插拔 USB。
4. 看是否有启动日志。

如果 115200 没日志或乱码，再试：

```text
9600
74880
921600
1500000
```

当前只要求看到“有启动输出”，不要求理解所有日志。

### 16.7 是否刷机

先不刷。

NiceMCU WB3S V1 可能是第三方 BK7238/BK 系列开发板，不等同于 T5AI-Core。后续如果只是玩，可以再评估：

- OpenBeken：偏智能家居/本地控制玩法。
- LibreTiny：偏 Arduino/PlatformIO 风格开发。

但刷第三方固件会覆盖原厂/卖家固件，且可能需要进入 boot/download 模式。等确认串口、电源、芯片型号后再决定。

### 16.8 记录模板

```text
日期：
板子丝印/型号：
插 USB 后新增串口：
5V 实测：
3V3 实测：
115200 是否有日志：
按 RST 是否有日志变化：
板子是否发热：
结论：通过 / 未通过
```

### 16.9 2026-05-26 NiceMCU 初次日志记录

```text
现象：
  Arduino Serial Monitor 能收到数据，但全部乱码
板上按键：
  无 RST
  有 RF 和 EN
当前判断：
  串口链路已有数据输出
  乱码优先按波特率不匹配处理
  EN 大概率可作为复位/使能按键使用
  RF 暂不长按，避免触发配网/测试/擦除类动作
下一步：
  用不同波特率逐个测试
  每次切换波特率后短按 EN 或重新插拔 USB
```

推荐波特率测试顺序：

```text
115200
9600
74880
38400
57600
921600
1500000
```

操作方式：

1. 关闭 Serial Monitor。
2. 改一个波特率。
3. 打开 Serial Monitor。
4. 短按 `EN`，或者拔插 USB。
5. 看日志是否变成可读英文/数字。

如果所有波特率都乱码：

- 确认串口监视器设置为 `No line ending` 或 `Both NL & CR` 均可尝试，但这通常不影响乱码。
- 确认不是同时被其他串口工具占用。
- 暂不刷机，先拍板子正反面确认芯片、串口芯片和丝印。

### 16.10 2026-05-26 NiceMCU 可读启动日志

```text
操作：
  短按 EN
结果：
  串口出现可读日志
关键日志：
  BK7238_1.0.14
  [I/FAL] Fal(V0.4.0)success
  [I/OTA] RT-Thread OTA package(V0.2.8-beken-1133282d-20220604) initialize success.
  go os_addr(0x10000)
  www.sparkleiot.com
  ready
当前判断：
  NiceMCU WB3S V1 上电正常
  串口通信正常
  EN 可作为复位/重启触发使用
  芯片/固件日志显示 BK7238 + RT-Thread/OTA 出厂固件
  当前无需刷机
```

下一步最小测试：

```text
1. 测 5V/GND 和 3V3/GND
2. 观察板子 1-2 分钟是否明显发热
3. 搜索手机 Wi-Fi/蓝牙列表，看是否出现 Sparkleiot/NiceMCU/BK/Tuya 类设备
4. 不接任何外部负载
```

### 16.11 查看 NiceMCU Wi-Fi/BLE 名称

目标：先尝试通过串口查询当前 Wi-Fi/BLE 信息，不刷机、不改配置。

当前依据：

- 板子日志显示 `BK7238_1.0.14`、`RT-Thread OTA`、`www.sparkleiot.com`、`ready`。
- 同类 NiceMCU XH-WB3S/BK7238 出厂固件可能带 AT 命令入口。
- BK7238 AT 指令通常使用 `AT+命令?` 作为查询命令，`AT+命令=...` 才是设置命令。

操作设置：

```text
串口：NiceMCU 新增串口
波特率：能看到 ready 的那个波特率，当前为 115200
Line ending：Both NL & CR 或 Newline + Carriage Return
```

先发最小命令：

```text
AT
```

若返回 `OK` 或类似响应，再依次尝试只读查询：

```text
AT+GMR
AT+CWMODE?
AT+CIPSTAMAC?
AT+CWSAP?
```

只读原则：

- 可以发送 `AT`。
- 可以发送以 `?` 结尾的查询命令。
- 暂不发送带 `=` 的设置命令，例如 `AT+CWSAP=...`。
- 暂不发送擦除、恢复出厂、配网、OTA、重启类命令。

如果 `AT+CIPSTAMAC?` 返回 MAC 地址，可以用 MAC 地址后 3 字节去手机 Wi-Fi/BLE 扫描列表里匹配设备。

如果 `AT+CWSAP?` 返回 SSID，即可知道板子 SoftAP 名称；如果无返回，说明当前固件可能未开启 SoftAP 或 AT 服务不完整。

### 16.12 2026-05-26 NiceMCU AT 查询结果

```text
AT:
  OK
AT+GMR:
  <ATVER:1.1>
  <SDKVER:3.0.70>
  OK
AT+CWMODE?:
  +WLMODE:1,1
  OK
AT+CIPSTAMAC?:
  +WLMAC:c8:47:8c:01:12:1f
  OK
AT+CWSAP?:
  ERROR
```

当前判断：

- NiceMCU WB3S V1 的出厂固件开放 AT 命令入口。
- 固件版本：`ATVER 1.1`，`SDKVER 3.0.70`。
- Wi-Fi MAC：`c8:47:8c:01:12:1f`。
- 手机 Wi-Fi/BLE 扫描时，可优先查找 MAC 后缀接近 `01:12:1f` 的设备。
- `AT+CWSAP?` 是常见 ESP-AT 风格命令，但该固件返回 `ERROR`，说明当前 Sparkleiot/BK7238 命令集不完全兼容 ESP-AT。

如何学习/查 AT 命令：

1. 先从启动日志提取关键词，例如：

```text
BK7238
Sparkleiot
ATVER
SDKVER
www.sparkleiot.com
```

2. 搜索资料时组合关键词：

```text
BK7238 AT command
Sparkleiot AT command
XH-WB3S AT command
BK7238 ATVER SDKVER
```

3. AT 命令通常有三类：

```text
AT              测试串口是否通
AT+XXX?         查询当前配置
AT+XXX=?        查询命令参数范围
AT+XXX=...      设置配置
```

4. 小白调试原则：

```text
优先发 AT 和带 ? 的查询命令
谨慎发带 = 的设置命令
暂不发 reset/restore/erase/ota/update 类命令
```

5. 不能假设所有 AT 固件都兼容 ESP-AT。`AT+CWSAP?` 报错就是例子：命令风格相似，但厂商命令集可能不同。

### 16.13 2026-05-26 NiceMCU Wi-Fi 扫描与入网记录

```text
AT+CWLAP:
  可扫描周围 Wi-Fi AP，返回 RSSI 与 BSSID/MAC 列表
AT+WSCAN:
  输出格式与 AT+CWLAP 基本一致，当前判断为扫描 Wi-Fi 的等效命令或别名
AT+CWJAP="SSID","password":
  返回 OK
  随后出现 WIFI CONNECTED
  随后出现 WIFI GOT IP
AT+CIFSR:
  +CIFSR:STAIP,"192.168.1.47"
  +CIFSR:STAMAC,"c8:47:8c:01:12:1f"
  OK
```

当前结论：

- NiceMCU WB3S V1 出厂 AT 固件可扫描 Wi-Fi。
- 可连接本地 Wi-Fi 并获取局域网 IP。
- 当前设备 IP 为 `192.168.1.47`。
- 当前设备 Wi-Fi MAC 为 `c8:47:8c:01:12:1f`。
- `AT+CWLAP` 与 `AT+WSCAN` 在当前固件里表现为同类扫描命令。

注意：

- 若 Wi-Fi 密码曾被复制到外部聊天或文档，建议后续更换测试 Wi-Fi 密码。
- 不再继续公开记录真实 Wi-Fi 密码。
