stcapo/slmw/firmware/t5_tuya_cct_app/secrets.example.h

#ifndef T5_TUYA_CCT_APP_SECRETS_H
#define T5_TUYA_CCT_APP_SECRETS_H

// Copy this file to secrets.h and fill in the values from Tuya Developer Platform.
#define APP_PRODUCT_ID       "your_product_id"
#define TUYA_DEVICE_UUID     "your_uuid"
#define TUYA_DEVICE_AUTHKEY  "your_authkey"

#endif
