stcapo/slmw/(commit log)

2026-05-28 Record warm channel power and drive checks
2026-05-28 Document final PWM drive solution
2026-05-28 Add GPIO override tests for PWM diagnosis
2026-05-28 Document logic analyzer PWM test plan
2026-05-28 Reduce firmware to minimal P24 P25 LA PWM test
2026-06-08 docs: translate phase2 pcb planning docs
2026-06-08 修改昵称
2026-06-08 docs: rename intern references to pcb engineer
